zhanglr77/tactile_gripper/README.md

# tactile_gripper
触觉夹抓项目代码仓库

# eit_dexhandarm_skin_simulator
触觉传感器和仿真器代码仓库
