zhanglr77/tactile_gripper/02_Finger_P2/02_Finger_P2_silicone.step

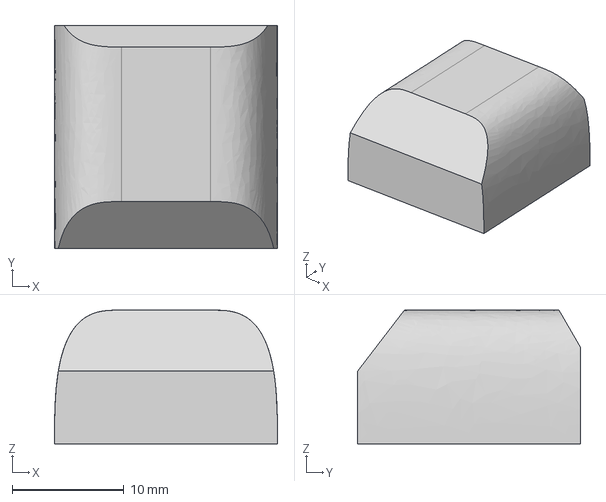
[picture p1: CAD file, 2026-10-31]
02_Finger_P2/02_Finger_P2_silicone.step
20.0 x 20.0 x 12.0 mm
