zhanglr77/tactile_gripper/03_Finger_P3/03_Finger_P3.step

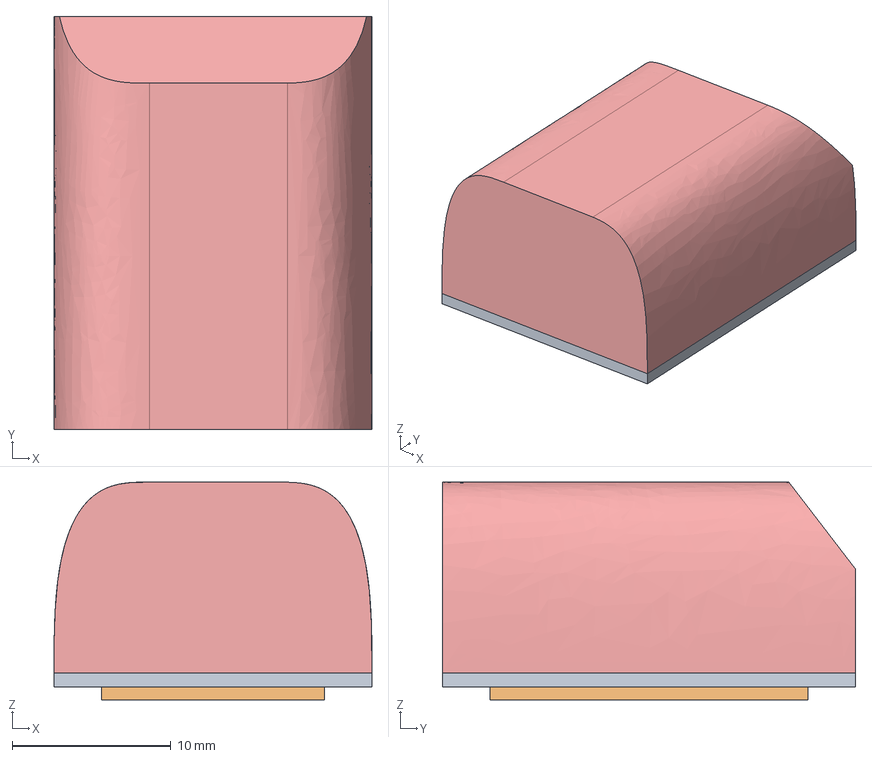
[picture p2: CAD file, 2026-10-31]
03_Finger_P3/03_Finger_P3.step
20.0 x 26.0 x 13.7 mm
pcb
3dhall MLX90393 x 4
a10
a25
mag d3x2 v1 x 6
