zhanglr77/tactile_gripper/04_Thumb_P1/04_Thumb_P1.step

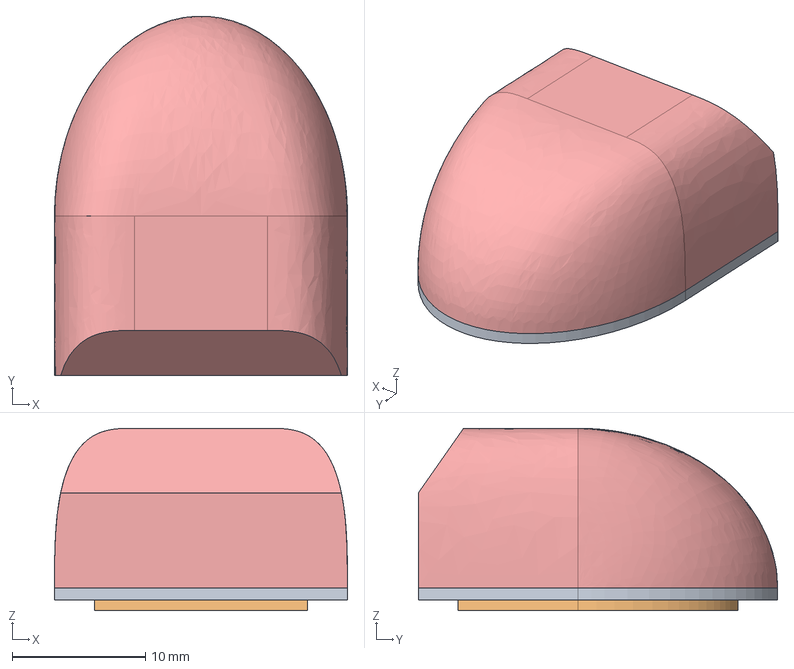
[picture p3: CAD file, 2026-10-31]
04_Thumb_P1/04_Thumb_P1.step
22.0 x 27.0 x 13.7 mm
pcb
3dhall MLX90393 x 4
a10
a25
mag d3x2 v1 x 6
