zhanglr77/tactile_gripper/05_Thumb_P2/05_Thumb_P2.step

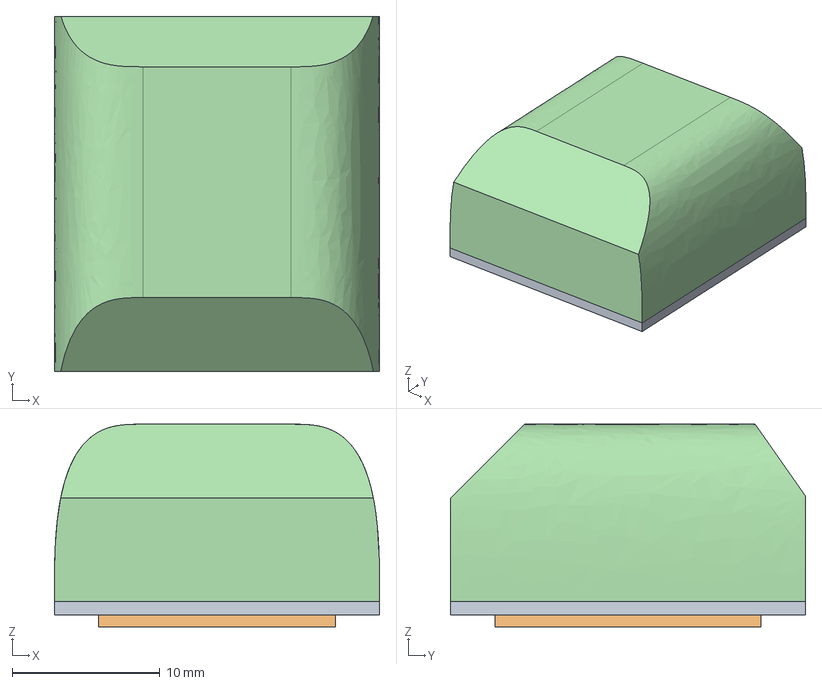
[picture p4: CAD file, 2026-10-31]
05_Thumb_P2/05_Thumb_P2.step
22.0 x 24.0 x 13.7 mm
pcb
3dhall MLX90393 x 4
a25
a10
mag d3x2 v1 x 6
