zhanglr77/tactile_gripper/07_Palm/07_Palm_silicone.step

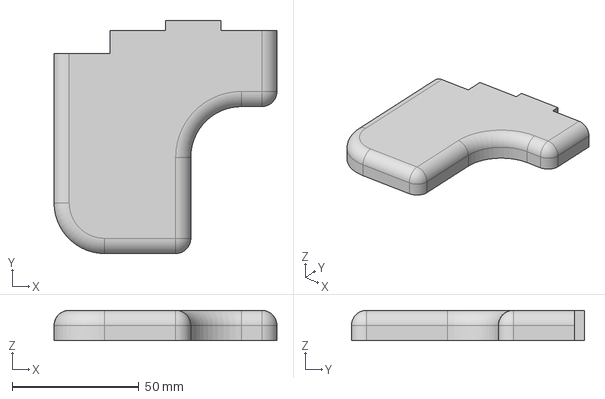
[picture p5: CAD file, 2026-10-31]
07_Palm/07_Palm_silicone.step
88.0 x 92.0 x 12.0 mm
