zhanglr77/tactile_gripper/DXF/08_Controller.DXF

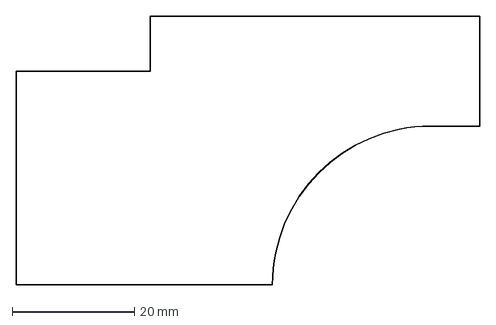
[picture p6: CAD file, 2026-10-31]
DXF/08_Controller.DXF
76.0 x 44.0 mm
