zhanglr77/tactile_gripper/Integrated_Hand_V1/01_Finger_P1/01_Finger_P1_silicone.step

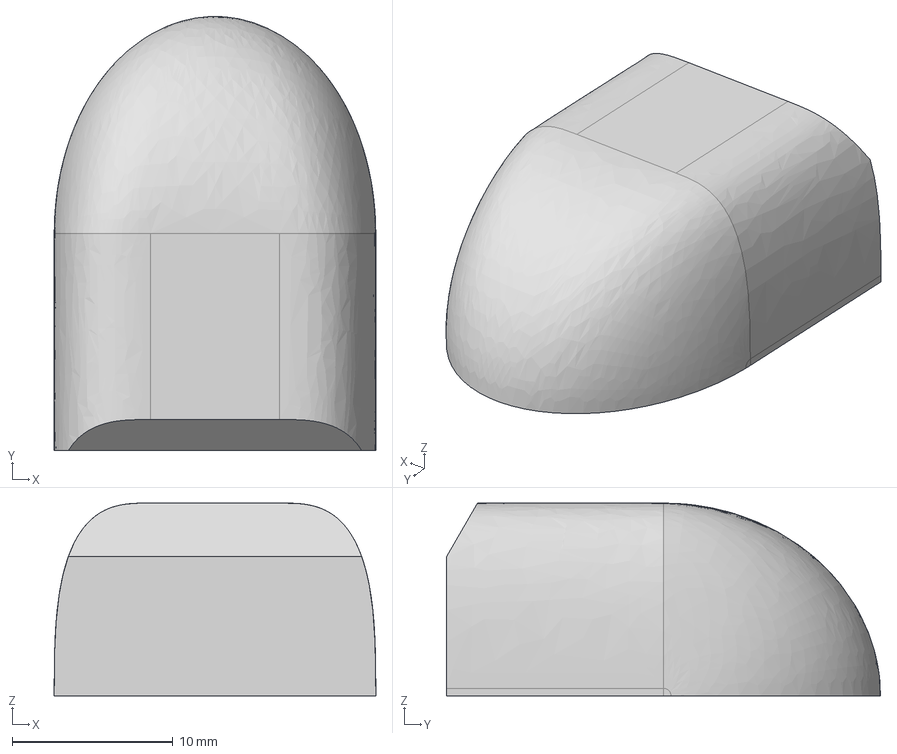
[picture p7: CAD file, 2026-10-31]
Integrated_Hand_V1/01_Finger_P1/01_Finger_P1_silicone.step
20.0 x 27.0 x 12.0 mm
