zhanglr77/tactile_gripper/Integrated_Hand_V1/02_Finger_P2/02_Finger_P2.step

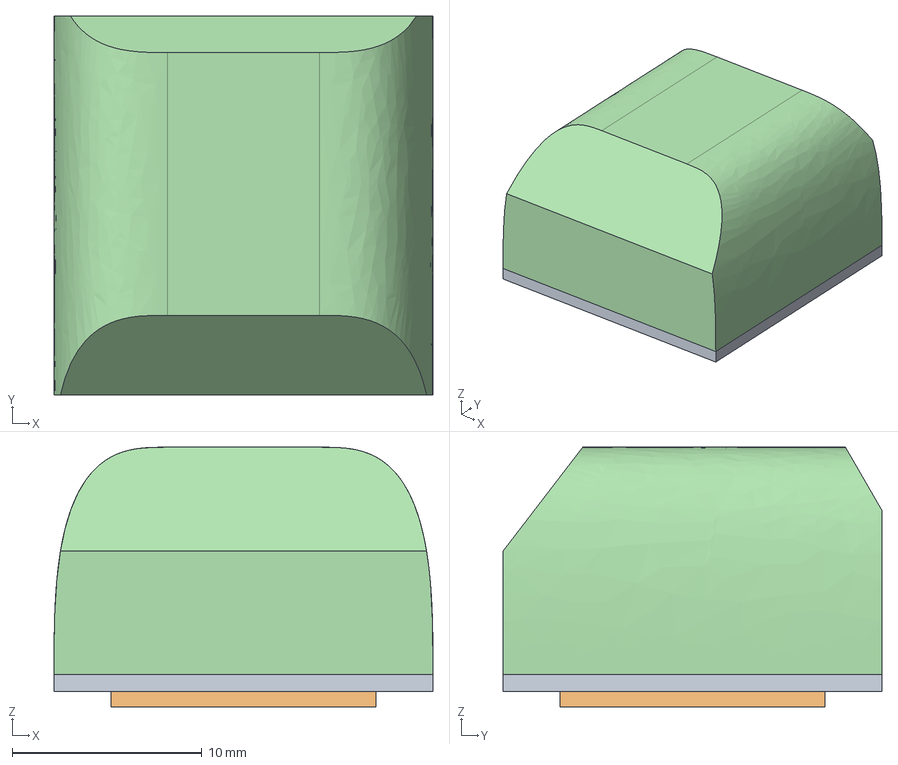
[picture p8: CAD file, 2026-10-31]
Integrated_Hand_V1/02_Finger_P2/02_Finger_P2.step
20.0 x 20.0 x 13.7 mm
pcb
3dhall MLX90393 x 4
a25
a10
mag d3x2 v1 x 6
