zhanglr77/tactile_gripper/Integrated_Hand_V1/03_Finger_P3/03_Finger_P3_silicone.step

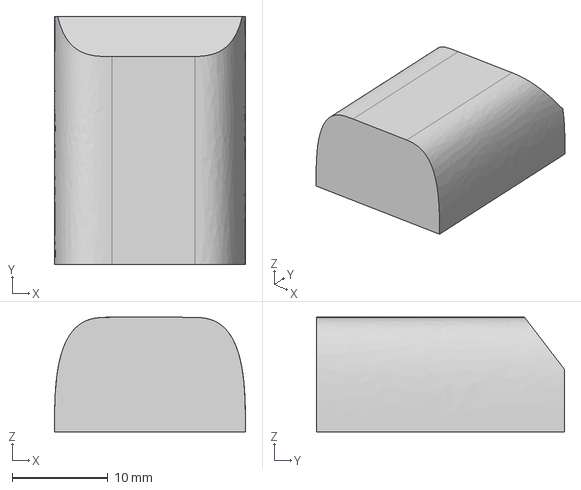
[picture p9: CAD file, 2026-10-31]
Integrated_Hand_V1/03_Finger_P3/03_Finger_P3_silicone.step
20.0 x 26.0 x 12.0 mm
