zhanglr77/tactile_gripper/Integrated_Hand_V1/DXF/01_Finger_P1_pcb.dxf

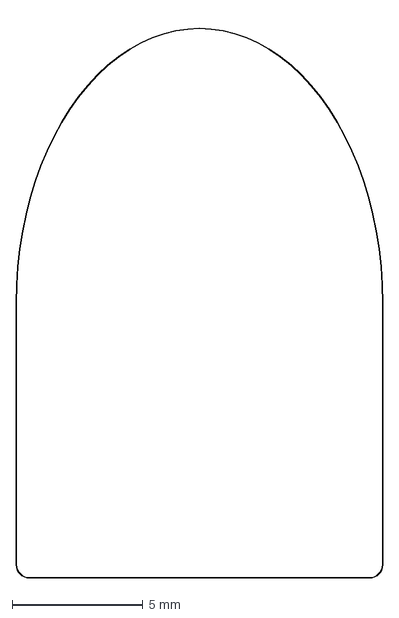
[picture p10: CAD file, 2026-10-31]
Integrated_Hand_V1/DXF/01_Finger_P1_pcb.dxf
14.0 x 21.5 mm
