zhanglr77/tactile_gripper/Integrated_Hand_V1/PCB/09_FPC-GH1.25_pcb.step

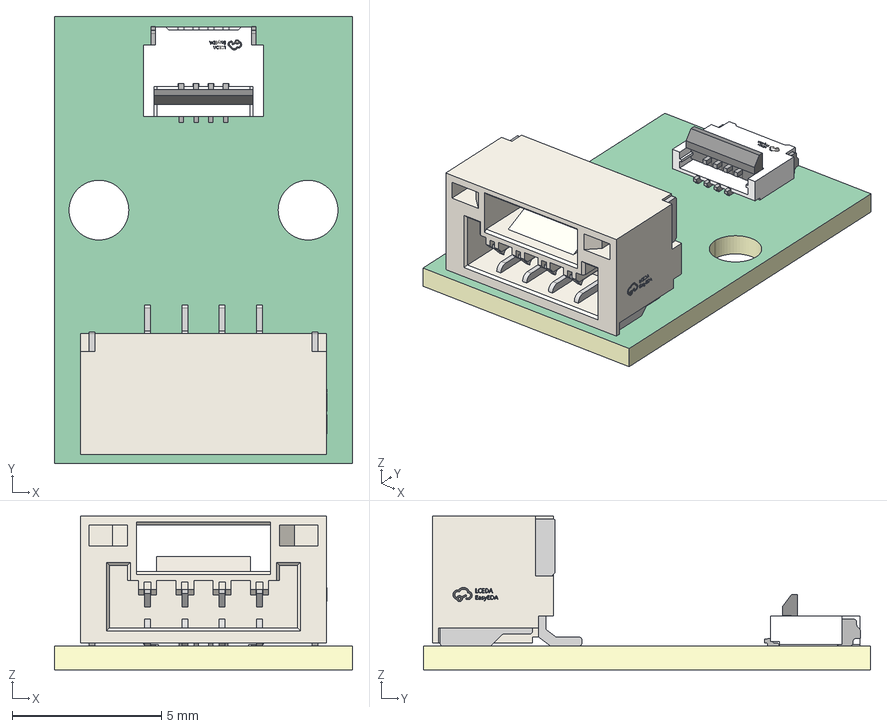
[picture p11: CAD file, 2026-10-31]
Integrated_Hand_V1/PCB/09_FPC-GH1.25_pcb.step
9.97 x 15.0 x 5.15 mm
Board~Tzaq
TopCopper~Tzaq
BottomCopper~Tzaq
TopSilkscreen~Tzaq
BottomSilkscreen~Tzaq
TopFpcStiffener~Tzaq
BottomFpcStiffener~Tzaq
FFC-SMD_4P-P0.50_F0504-H-04-10G-R~FFC-SMD_4P-P0.50_F0504-H-04-10G-R~e24O
CONN-SMD_4P-P1.25_XUNPU_WAFER-GH1.25-4PWB~CONN-SMD_4P-P1.25_XUNPU_WAFER-GH1.25-4PWB~bdfr
