zhanglr77/tactile_gripper/PCB/04_Thumb_P1_pcb.step

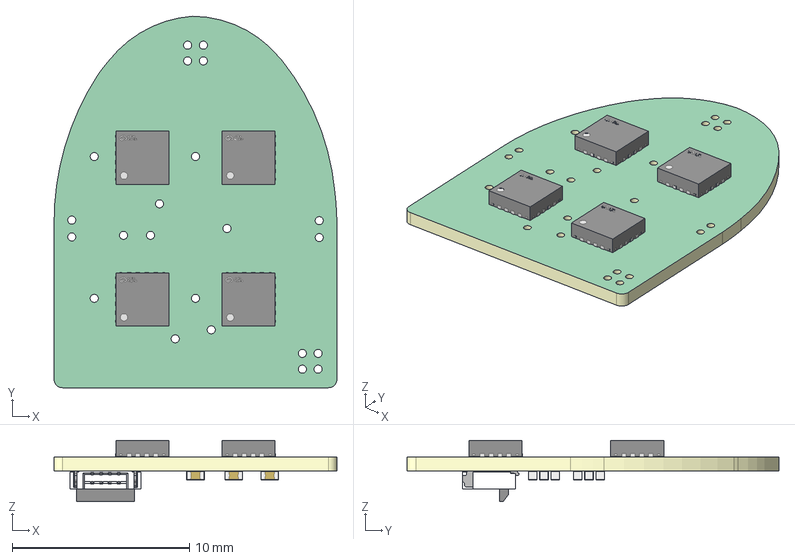
[picture p12: CAD file, 2026-10-31]
PCB/04_Thumb_P1_pcb.step
16.0 x 21.0 x 3.45 mm
Board~Tk6Q
TopCopper~Tk6Q
BottomCopper~Tk6Q
TopSilkscreen~Tk6Q
BottomSilkscreen~Tk6Q
TopFpcStiffener~Tk6Q
BottomFpcStiffener~Tk6Q
FFC-SMD_4P-P0.50_F0504-H-04-10G-R~FFC-SMD_4P-P0.50_F0504-H-04-10G-R~zIWl
C0402~C0402_L1.0-W0.5-H0.5~qsHK x 8
VQFN-16_L3.0-W3.0-P0.50-BL-EP1.7~VQFN-16_L3.0-W3.0-P0.50-BL-EP1.7~lIwn x 4
