zhanglr77/tactile_gripper/sensor_project/geometry/v2_silicone.step

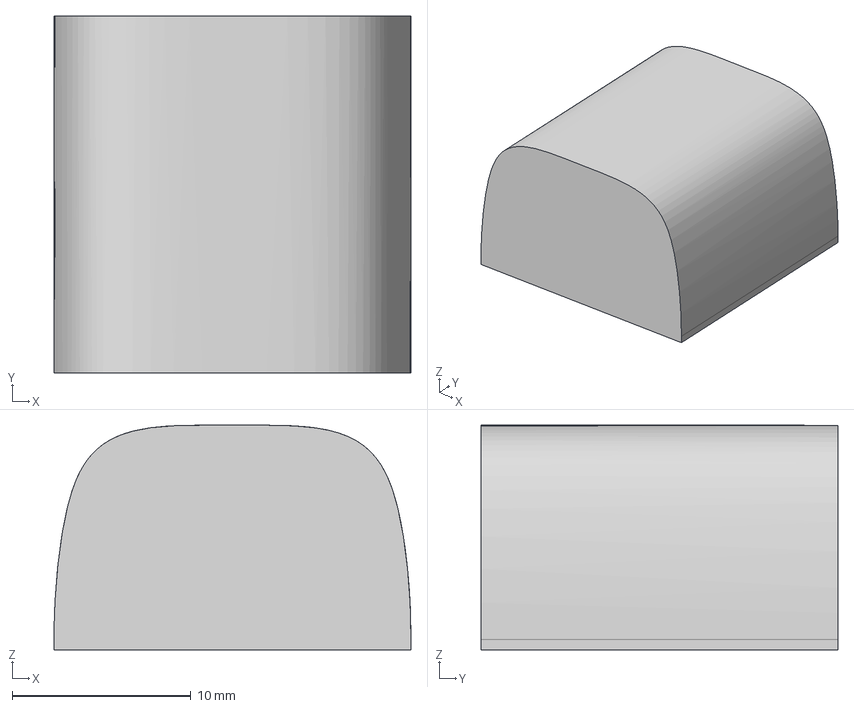
[picture p13: CAD file, 2026-10-28]
sensor_project/geometry/v2_silicone.step
20.0 x 20.0 x 12.6 mm
