zhanglr77/tactile_gripper/04_Thumb_P1/04_Thumb_P1_silicone.step

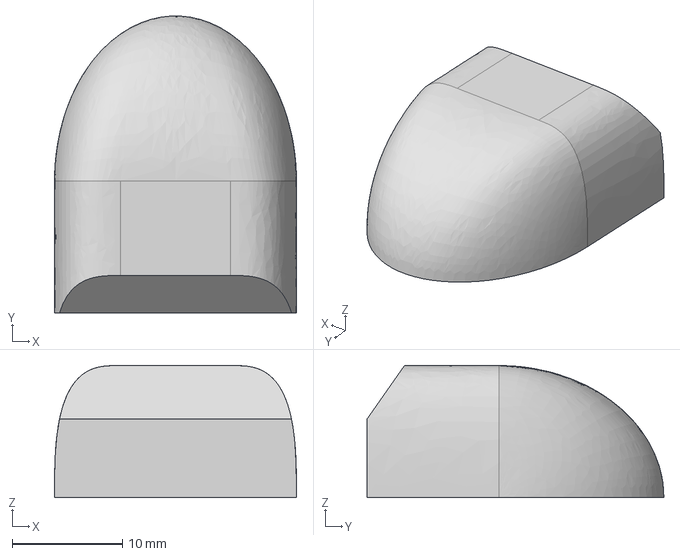
[picture p14: CAD file, 2026-10-31]
04_Thumb_P1/04_Thumb_P1_silicone.step
22.0 x 27.0 x 12.0 mm
