zhanglr77/tactile_gripper/05_Thumb_P2/05_Thumb_P2_silicone.step

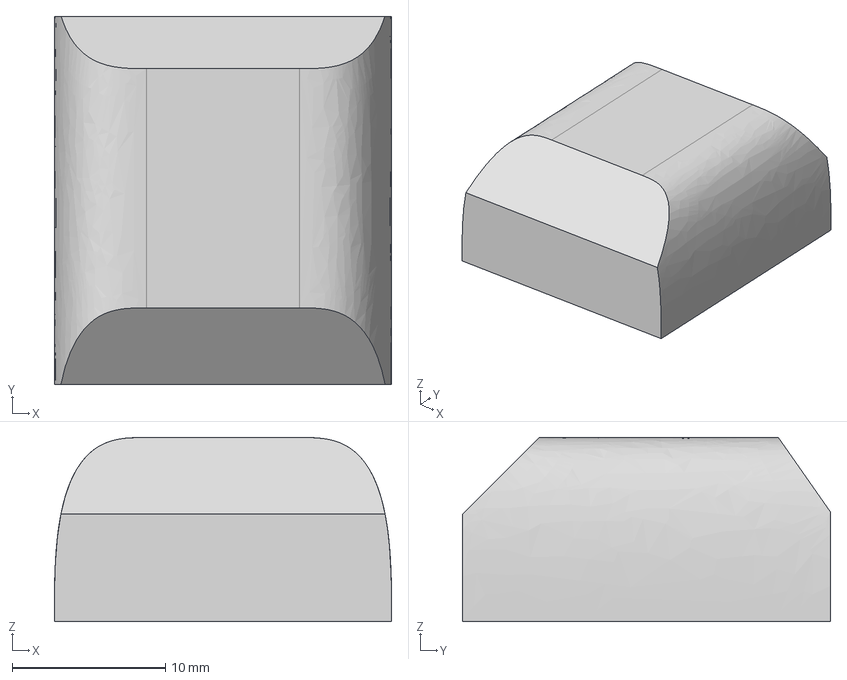
[picture p15: CAD file, 2026-10-31]
05_Thumb_P2/05_Thumb_P2_silicone.step
22.0 x 24.0 x 12.0 mm
