zhanglr77/tactile_gripper/07_Palm/07_Palm.step

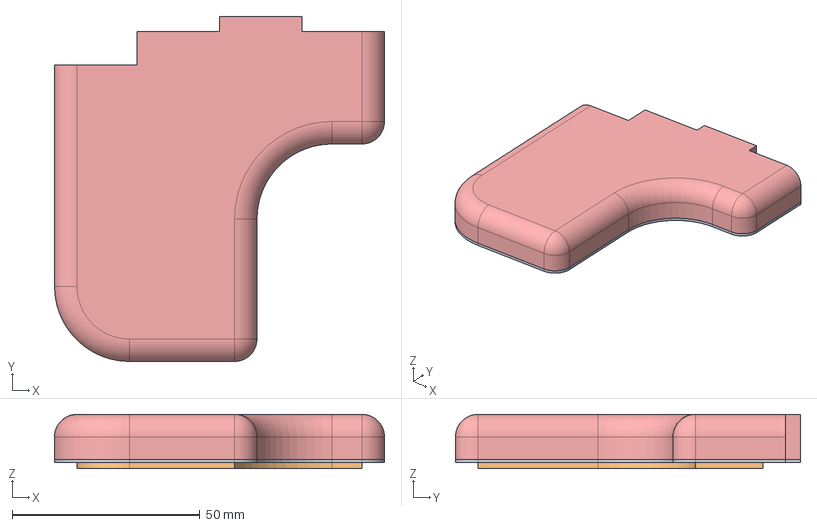
[picture p16: CAD file, 2026-10-31]
07_Palm/07_Palm.step
88.0 x 92.0 x 14.5 mm
pcb
3dhall MLX90393 x 16
a10
a25
mag d3x2 v1 x 16
