zhanglr77/tactile_gripper/Integrated_Hand_V1/01_Finger_P1/01_Finger_P1.step

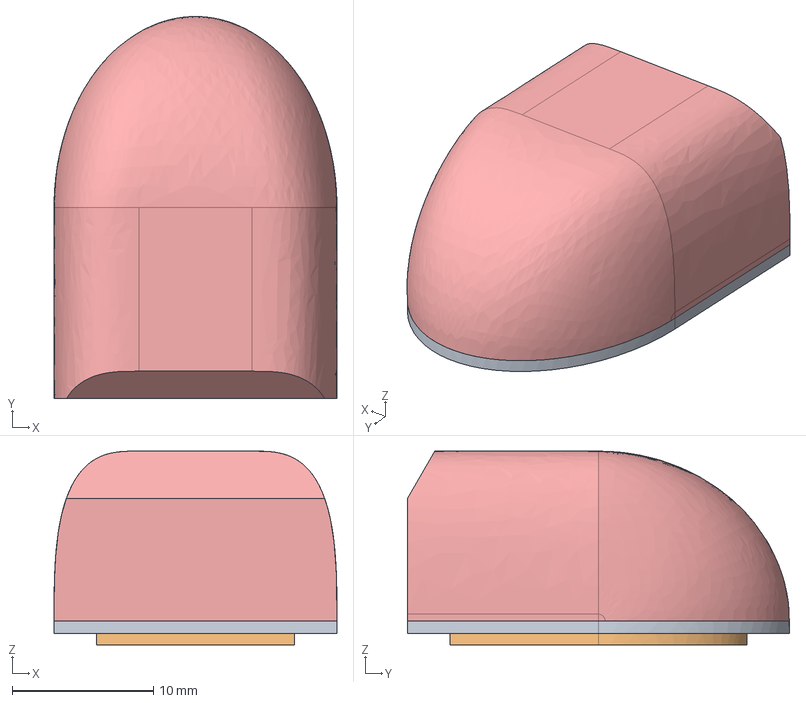
[picture p17: CAD file, 2026-10-31]
Integrated_Hand_V1/01_Finger_P1/01_Finger_P1.step
20.0 x 27.0 x 13.7 mm
pcb
3dhall MLX90393 x 4
mag d3x2 v1 x 6
a25
a10
