zhanglr77/tactile_gripper/Integrated_Hand_V1/DXF/07_Palm.DXF

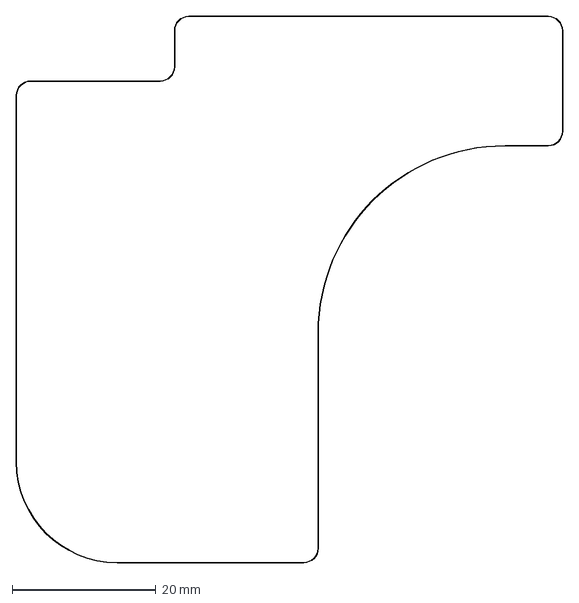
[picture p18: CAD file, 2026-10-31]
Integrated_Hand_V1/DXF/07_Palm.DXF
76.0 x 76.0 mm
