zhanglr77/tactile_gripper/Integrated_Hand_V1/PCB/02_Finger_P2_pcb.step

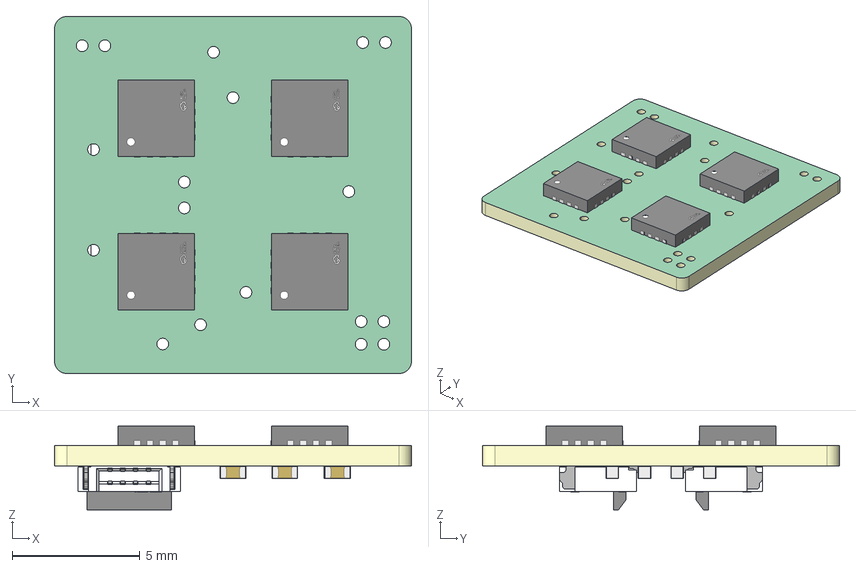
[picture p19: CAD file, 2026-10-31]
Integrated_Hand_V1/PCB/02_Finger_P2_pcb.step
14.0 x 14.0 x 3.28 mm
Board~RPdZ
TopCopper~RPdZ
BottomCopper~RPdZ
TopSilkscreen~RPdZ
BottomSilkscreen~RPdZ
TopFpcStiffener~RPdZ
BottomFpcStiffener~RPdZ
FFC-SMD_4P-P0.50_F0504-H-04-10G-R~FFC-SMD_4P-P0.50_F0504-H-04-10G-R~pqgl x 2
C0402~C0402_L1.0-W0.5-H0.5~yeJp x 8
QFN-16_L3.0-W3.0-P0.50-BL-EP1.7~QFN-16_L3.0-W3.0-P0.50-EP1.7~FqRe x 4
