zhanglr77/tactile_gripper/PCB/01_Finger_P1_pcb.step

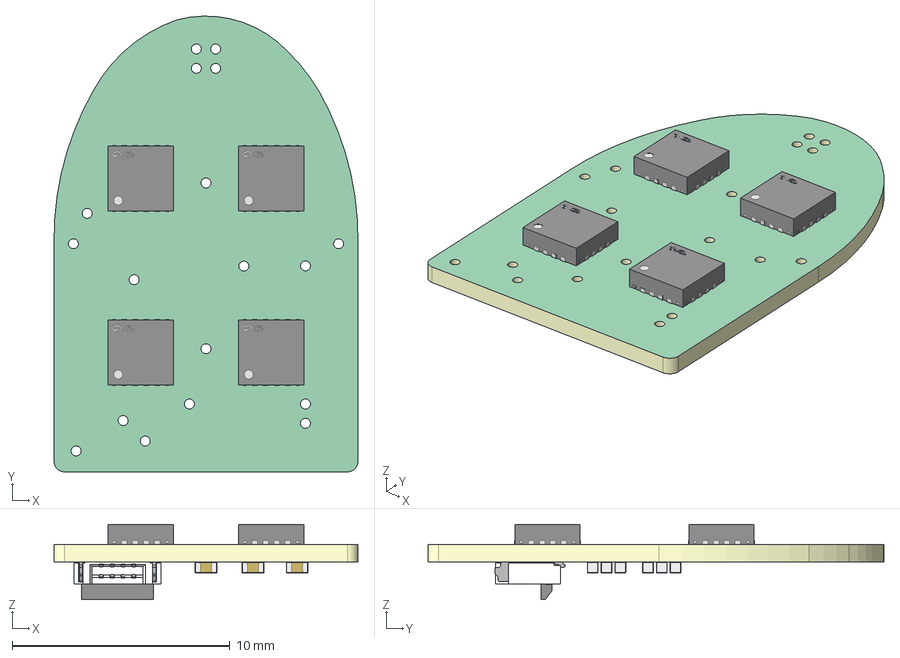
[picture p20: CAD file, 2026-10-31]
PCB/01_Finger_P1_pcb.step
14.0 x 21.0 x 3.45 mm
Board~L7ew
TopCopper~L7ew
BottomCopper~L7ew
TopSilkscreen~L7ew
BottomSilkscreen~L7ew
TopFpcStiffener~L7ew
BottomFpcStiffener~L7ew
C0402~C0402_L1.0-W0.5-H0.5~U7W7 x 8
FFC-SMD_4P-P0.50_F0504-H-04-10G-R~FFC-SMD_4P-P0.50_F0504-H-04-10G-R~b74c
VQFN-16_L3.0-W3.0-P0.50-BL-EP1.7~VQFN-16_L3.0-W3.0-P0.50-BL-EP1.7~sbWL x 4
