zhanglr77/tactile_gripper/Integrated_Hand_V1/DXF/04_Thumb_P1_pcb.dxf

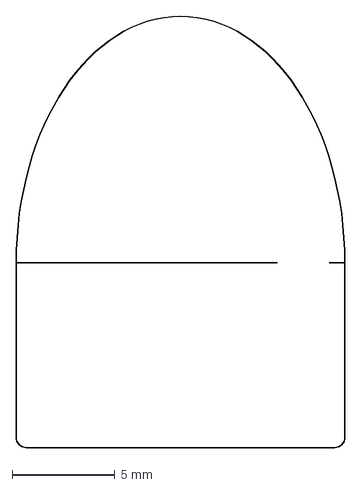
[picture p21: CAD file, 2026-10-31]
Integrated_Hand_V1/DXF/04_Thumb_P1_pcb.dxf
16.0 x 21.0 mm
