zhanglr77/tactile_gripper/Integrated_Hand_V1/PCB/03_Finger_P3_pcb.step

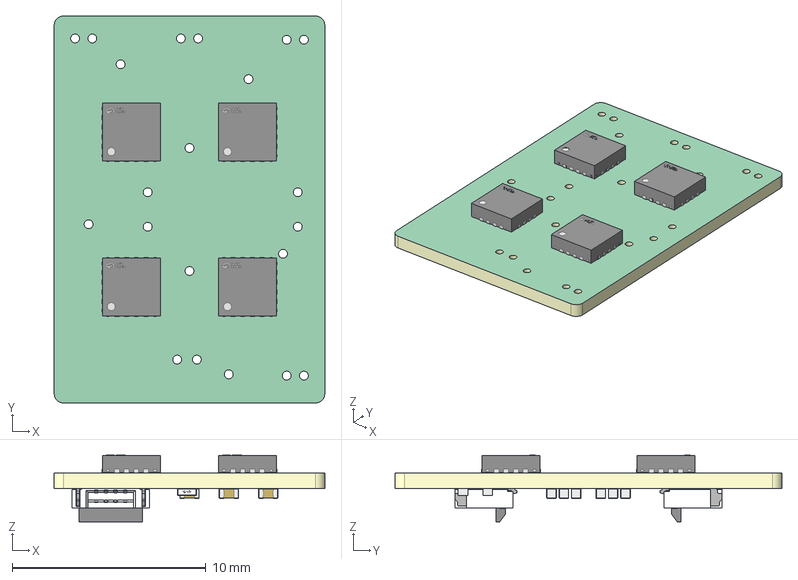
[picture p22: CAD file, 2026-10-31]
Integrated_Hand_V1/PCB/03_Finger_P3_pcb.step
14.0 x 20.0 x 3.45 mm
Board~LH1f
TopCopper~LH1f
BottomCopper~LH1f
TopSilkscreen~LH1f
BottomSilkscreen~LH1f
TopFpcStiffener~LH1f
BottomFpcStiffener~LH1f
R0402~R0402_L1.0-W0.5-H0.4~Fswv x 2
C0402~C0402_L1.0-W0.5-H0.5~sbaw x 8
FFC-SMD_4P-P0.50_F0504-H-04-10G-R~FFC-SMD_4P-P0.50_F0504-H-04-10G-R~qZHC x 2
VQFN-16_L3.0-W3.0-P0.50-BL-EP1.7~VQFN-16_L3.0-W3.0-P0.50-BL-EP1.7~8wsD x 4
