zhanglr77/tactile_gripper/Integrated_Hand_V1/PCB/05_Thumb_P2_pcb.step

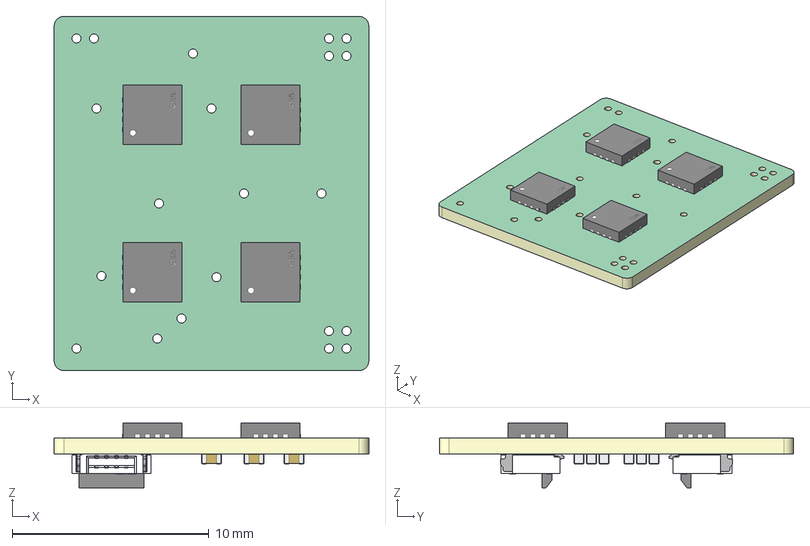
[picture p23: CAD file, 2026-10-31]
Integrated_Hand_V1/PCB/05_Thumb_P2_pcb.step
16.0 x 18.0 x 3.28 mm
Board~O58B
TopCopper~O58B
BottomCopper~O58B
TopSilkscreen~O58B
BottomSilkscreen~O58B
TopFpcStiffener~O58B
BottomFpcStiffener~O58B
QFN-16_L3.0-W3.0-P0.50-BL-EP1.7~QFN-16_L3.0-W3.0-P0.50-EP1.7~V6qV x 4
C0402~C0402_L1.0-W0.5-H0.5~j9TB x 8
FFC-SMD_4P-P0.50_F0504-H-04-10G-R~FFC-SMD_4P-P0.50_F0504-H-04-10G-R~xzFR x 2
