zhanglr77/tactile_gripper/Project_02_New_Gripper_Design/hardware/experiment_results/open_close_20260916_031037_721431625.csv

time_s | phase | left_n | right_n | sample_timestamp | position_rad | velocity_rad_s | command_position_rad | feedforward_nm | motor_kp | motor_kd | event
0.1741551499981142 | ZERO_VERIFY | 0.0 | 0.0 | 23710.436210256 | 1.8883039597161826 | -15.521367521367495 | 1.8883039597161826 | 0 | 0 | 0
0.18499644600160536 | ZERO_VERIFY | 0.0 | 0.0 | 23710.446925806 | 1.8892195010299844 | -14.56410256410254 | 1.8892195010299844 | 0 | 0 | 0
0.1955932720011333 | ZERO_VERIFY | 0.0 | 0.0 | 23710.458051448 | 1.8892195010299844 | -14.153846153846132 | 1.8892195010299844 | 0 | 0 | 0
0.20658427500166 | ZERO_VERIFY | 0.0 | 0.0 | 23710.46876007 | 1.8883039597161826 | -13.88034188034186 | 1.8883039597161826 | 0 | 0 | 0
0.21754875699843979 | ZERO_VERIFY | 0.0 | 0.0 | 23710.479816338 | 1.8892195010299844 | -13.743589743589723 | 1.8892195010299844 | 0 | 0 | 0
0.22842301900163875 | ZERO_VERIFY | 0.0 | 0.0 | 23710.490906643 | 1.8892195010299844 | -13.743589743589723 | 1.8892195010299844 | 0 | 0 | 0
0.23930915600067237 | ZERO_VERIFY | 0.0 | 0.0 | 23710.501810669 | 1.8892195010299844 | -13.743589743589723 | 1.8892195010299844 | 0 | 0 | 0
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
