zhanglr77/tactile_gripper/Project_02_New_Gripper_Design/hardware/experiment_results/open_close_20260916_031618_181375480.csv

time_s | phase | left_n | right_n | sample_timestamp | position_rad | velocity_rad_s | command_position_rad | feedforward_nm | motor_kp | motor_kd | event
12.14378979400135 | ZERO_VERIFY | 0.0 | 0.0 | 24062.866096849 | 28.263218127718012 | -0.06837606837609655 | 28.263218127718012 | 0 | 0 | 0
12.154829688999598 | ZERO_VERIFY | 0.0 | 0.0 | 24062.877040291 | 28.263218127718012 | -0.06837606837609655 | 28.263218127718012 | 0 | 0 | 0
12.165813514999172 | ZERO_VERIFY | 0.0 | 0.0 | 24062.888024043 | 28.263218127718012 | -0.06837606837609655 | 28.263218127718012 | 0 | 0 | 0
12.176815749000525 | ZERO_VERIFY | 0.0 | 0.0 | 24062.899034145 | 28.263218127718012 | -0.06837606837609655 | 28.263218127718012 | 0 | 0 | 0
12.187857381999493 | ZERO_VERIFY | 0.0 | 0.0 | 24062.909892661 | 28.263218127718012 | -0.06837606837609655 | 28.263218127718012 | 0 | 0 | 0
12.198688766999112 | ZERO_VERIFY | 0.0 | 0.0 | 24062.921067863 | 28.26230258640421 | -0.06837606837609655 | 28.26230258640421 | 0 | 0 | 0
12.210040339999978 | ZERO_VERIFY | 0.0 | 0.0 | 24062.932089362 | 28.263218127718012 | -0.06837606837609655 | 28.263218127718012 | 0 | 0 | 0
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
