zhanglr77/tactile_gripper/Project_02_New_Gripper_Design/hardware/experiment_results/open_close_20260916_032047_187472892.csv

time_s | phase | left_n | right_n | sample_timestamp | position_rad | velocity_rad_s | command_position_rad | feedforward_nm | motor_kp | motor_kd | event
0.39227654400019674 | ZERO_VERIFY | 0.0 | 0.0 | 24320.120439384 | 28.255893797207598 | -0.06837606837609655 | 28.255893797207598 | 0 | 0 | 0
0.40364654699806124 | ZERO_VERIFY | 0.0 | 0.0 | 24320.131395122 | 28.255893797207598 | -0.06837606837609655 | 28.255893797207598 | 0 | 0 | 0
0.41393848399820854 | ZERO_VERIFY | 0.0 | 0.0 | 24320.142470835 | 28.255893797207598 | -0.06837606837609655 | 28.255893797207598 | 0 | 0 | 0
0.4248696119975648 | ZERO_VERIFY | 0.0 | 0.0 | 24320.153342554 | 28.255893797207598 | -0.06837606837609655 | 28.255893797207598 | 0 | 0 | 0
0.4358799209985591 | ZERO_VERIFY | 0.0 | 0.0 | 24320.164349186 | 28.255893797207598 | -0.06837606837609655 | 28.255893797207598 | 0 | 0 | 0
0.4469062899988785 | ZERO_VERIFY | 0.0 | 0.0 | 24320.175442248 | 28.255893797207598 | -0.06837606837609655 | 28.255893797207598 | 0 | 0 | 0
0.4584440469989204 | ZERO_VERIFY | 0.0 | 0.0 | 24320.186471656 | 28.255893797207598 | -0.06837606837609655 | 28.255893797207598 | 0 | 0 | 0
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
