zhanglr77/tactile_gripper/sensor_project/results/P25_Np00_Y0_hall_endpoints.csv

step | frame | step_time | total_time | hall1_Bx_mT | hall1_By_mT | hall1_Bz_mT | hall1_Bmag_mT | hall1_delta_Bx_mT | hall1_delta_By_mT | hall1_delta_Bz_mT | hall1_delta_Bmag_mT | hall2_Bx_mT | hall2_By_mT | hall2_Bz_mT | hall2_Bmag_mT | hall2_delta_Bx_mT | hall2_delta_By_mT | hall2_delta_Bz_mT | hall2_delta_Bmag_mT | hall3_Bx_mT | hall3_By_mT | hall3_Bz_mT | hall3_Bmag_mT | hall3_delta_Bx_mT | hall3_delta_By_mT | hall3_delta_Bz_mT | hall3_delta_Bmag_mT | hall4_Bx_mT | hall4_By_mT | hall4_Bz_mT | hall4_Bmag_mT | hall4_delta_Bx_mT | hall4_delta_By_mT | hall4_delta_Bz_mT | hall4_delta_Bmag_mT
Step-contact | 0 | 0.0 | 0.0 | 17.68 | -0.00 | 17.34 | 24.77 | 0.00 | 0.00 | 0.00 | 0.00 | 0.00 | 11.71 | -4.35 | 12.49 | 0.00 | 0.00 | 0.00 | 0.00 | -17.68 | 0.00 | 17.34 | 24.77 | 0.00 | 0.00 | 0.00 | 0.00 | -0.00 | -11.71 | -4.35 | 12.49 | 0.00 | 0.00 | 0.00 | 0.00
Step-compression-06 | 14 | 1.0 | 7.0 | 26.45 | 0.04 | 39.89 | 47.86 | 8.77 | 0.04 | 22.55 | 23.09 | -0.00 | 10.19 | -3.27 | 10.70 | -0.00 | -1.52 | 1.08 | -1.79 | -26.49 | -0.02 | 40.06 | 48.02 | -8.81 | -0.02 | 22.72 | 23.26 | -0.01 | -10.19 | -3.27 | 10.70 | -0.01 | 1.53 | 1.08 | -1.79
