zhanglr77/tactile_gripper/sensor_project/results/P25_Np00_Y0_mag_poses.csv

step | frame | step_time | total_time | mag1_x | mag1_y | mag1_z | mag1_ur1_rad | mag1_ur2_rad | mag1_ur3_rad | mag2_x | mag2_y | mag2_z | mag2_ur1_rad | mag2_ur2_rad | mag2_ur3_rad | mag3_x | mag3_y | mag3_z | mag3_ur1_rad | mag3_ur2_rad | mag3_ur3_rad | mag4_x | mag4_y | mag4_z | mag4_ur1_rad | mag4_ur2_rad | mag4_ur3_rad | mag5_x | mag5_y | mag5_z | mag5_ur1_rad | mag5_ur2_rad | mag5_ur3_rad | mag6_x | mag6_y | mag6_z | mag6_ur1_rad | mag6_ur2_rad | mag6_ur3_rad
Step-contact | 0 | 0.0 | 0.0 | 0.0 | -5.0 | 4.0 | 0.0 | 0.0 | 0.0 | 0.0 | 5.0 | 4.0 | 0.0 | 0.0 | 0.0 | 6.0 | -5.0 | 3.0 | 0.0 | 0.0 | 0.0 | 6.0 | 5.0 | 3.0 | 0.0 | 0.0 | 0.0 | -6.0 | -5.0 | 3.0 | 0.0 | 0.0 | 0.0 | -6.0 | 5.0 | 3.0 | 0.0 | 0.0 | 0.0
Step-contact | 1 | 0.10000000149011612 | 0.10000000149011612 | 0.0 | -5.0 | 4.0 | 0.0 | 0.0 | 0.0 | 0.0 | 5.0 | 4.0 | 0.0 | 0.0 | 0.0 | 6.0 | -5.0 | 3.0 | 0.0 | 0.0 | 0.0 | 6.0 | 5.0 | 3.0 | 0.0 | 0.0 | 0.0 | -6.0 | -5.0 | 3.0 | 0.0 | 0.0 | 0.0 | -6.0 | 5.0 | 3.0 | 0.0 | 0.0 | 0.0
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
