zhanglr77/tactile_gripper/sensor_project/results/comparison_summary.csv

case_id | no_cavities_mu05_cpus1_seconds | cavities_mu05_cpus4_seconds | no_cavities_status | cavities_status
P25_Np00_Y0 | 5755 | 2945 | COMPLETED | COMPLETED
S8_Nm45_Ym4 | 3907 | 2323 | COMPLETED | COMPLETED
S8_Nm45_Yp4 | 3950 | 2345 | COMPLETED | COMPLETED
S8_Np00_Ym4 | 3997 | 2330 | COMPLETED | COMPLETED
S8_Np00_Yp4 | 4199 | 2413 | COMPLETED | COMPLETED
S8_Np45_Ym4 | 3954 | 2288 | COMPLETED | COMPLETED
S8_Np45_Yp4 | 4031 | 2329 | COMPLETED | COMPLETED
