zhanglr77/tactile_gripper/sensor_project/results/compression_summary.csv

case_id | status | compression_mm | friction | cpus | wallclock_seconds | wallclock_minutes | analysis_warnings | errors | odb_path | restart_available
P25_Nm45_Y0 | COMPLETED | 3 | 0.5 | 4 | 1235 | 20.58 | 5 | 0 | abaqus_output/analytic_rigid_cavities_mu05_cpus4/P25_Nm45_Y0/Job-P25_Nm45_Y0.odb | False
P25_Np00_Y0 | COMPLETED | 3 | 0.5 | 4 | 2945 | 49.08 | 21 | 0 | abaqus_output/analytic_rigid_cavities_mu05_cpus4/P25_Np00_Y0/Job-P25_Np00_Y0.odb | False
P25_Np45_Y0 | COMPLETED | 3 | 0.5 | 4 | 1210 | 20.17 | 3 | 0 | abaqus_output/analytic_rigid_cavities_mu05_cpus4/P25_Np45_Y0/Job-P25_Np45_Y0.odb | False
S8_Nm45_Ym4 | COMPLETED | 3 | 0.5 | 4 | 2323 | 38.72 | 3 | 0 | abaqus_output/analytic_rigid_cavities_mu05_cpus4/S8_Nm45_Ym4/Job-S8_Nm45_Ym4.odb | False
S8_Nm45_Yp4 | COMPLETED | 3 | 0.5 | 4 | 2345 | 39.08 | 3 | 0 | abaqus_output/analytic_rigid_cavities_mu05_cpus4/S8_Nm45_Yp4/Job-S8_Nm45_Yp4.odb | False
S8_Np00_Ym4 | COMPLETED | 3 | 0.5 | 4 | 2330 | 38.83 | 4 | 0 | abaqus_output/analytic_rigid_cavities_mu05_cpus4/S8_Np00_Ym4/Job-S8_Np00_Ym4.odb | False
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
