zhanglr77/tactile_gripper/(commit log)

2026-09-30 add tactile simulator
    [open_close_20260916_031037_721431625.csv, open_close_20260916_031618_181375480.csv, open_close_20260916_032047_187472892.csv]
2026-10-28 Add v2 sensor simulation project
2026-10-31 Update sensor project surrogate plan
2026-10-31 Add Integrated Hand V1 CAD and configuration files
